ph557787-cell/IoT-Fire-Alarm-System/(list of files, drawings)

Other design files:
Altium_Design/`schemetic phongbep.SchDoc
Altium_Design/pcb gara.PcbDoc
Altium_Design/pcb phong khach.PcbDoc
Altium_Design/pcbphongbep.PcbDoc
Altium_Design/schemetic gara.SchDoc
Altium_Design/schemetic phong khach.SchDoc
